theraiserson/airlogger/README.md

# Airlogger

Air quality to MQTT logger

## Breadboard
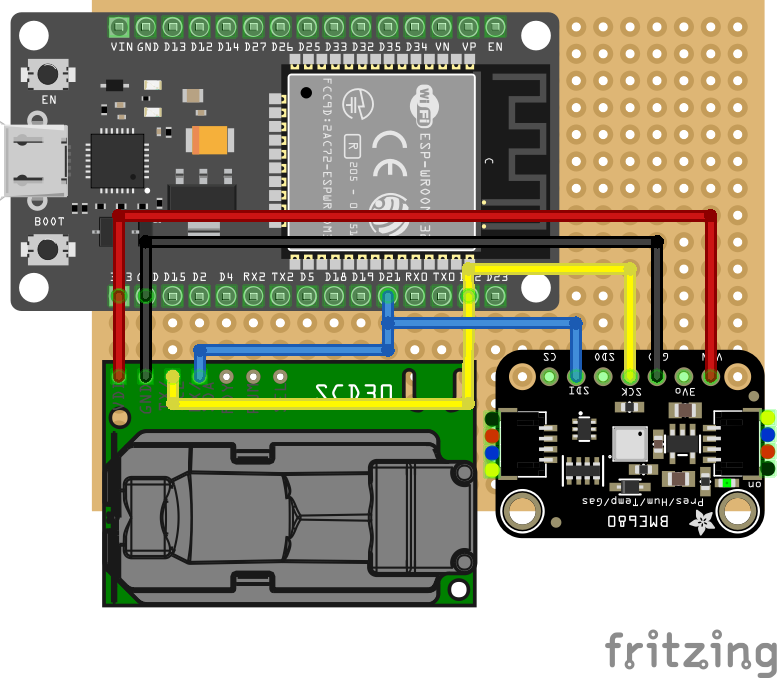
[picture p1: docs/Airlogger_bb.png]
Breadboard


## Schematic
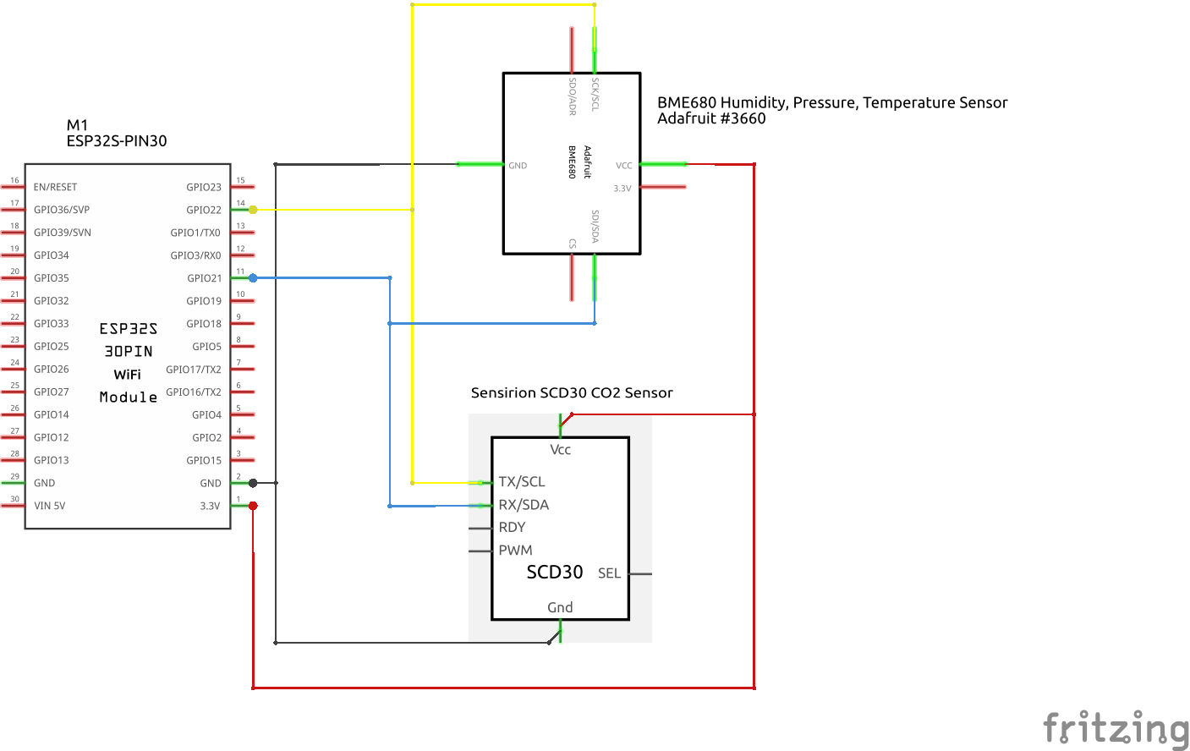
[picture p2: docs/Airlogger_schem.png]
Schematic
