theraiserson/airlogger/docs/case/Airlogger Case Body.FCStd

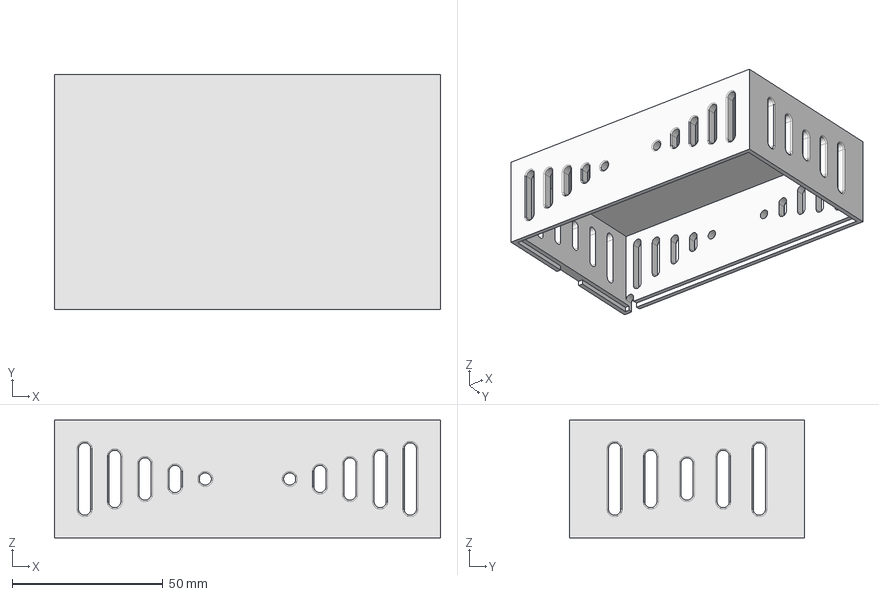
[picture p3: CAD file, 2021-12-17]
docs/case/Airlogger Case Body.FCStd
128.0 x 78.0 x 39.0 mm
