theraiserson/airlogger/docs/case/Airlogger Case Floor.FCStd

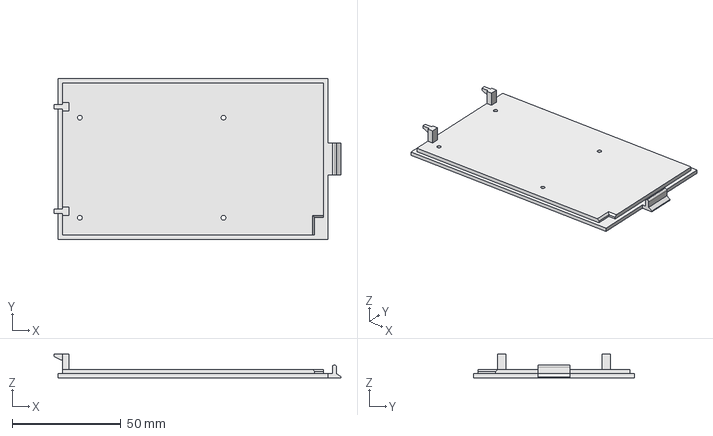
[picture p4: CAD file, 2021-12-17]
docs/case/Airlogger Case Floor.FCStd
131.9 x 74.0 x 10.9 mm
