theraiserson/airlogger/(list of files, cad)

Other CAD files:
docs/case/Airlogger Case Floor.stl
