theraiserson/airlogger/(list of files, drawings)

Other design files:
docs/Airlogger.fzz
