theraiserson/airlogger/(commit log)

2020-11-06 Add support for ESP32
    Project environment for PlatformIO can be choosen in the status bar
2020-11-10 Switch to BSEC and add MQTT
    * Switch from Adafruit BME680 library to BSEC
    * Add basic MQTT publishing to local server
2020-11-29 Fix pressure: Needs to be divided by 100 to reflect hPa
    [main.cpp]
2020-11-29 Read SCD30 in independently timed (5 sec) loop
    Also update SCD30 with pressure readings from BME680 every five minutes
2021-01-24 Setup: Log current SCD30 settings
    Since they are persisted on the sensors memory, they might have
    unexpected values
2021-01-24 Setup: Add 100ms delay to allow SCD30 to boot
    As seen here: https://github.com/sparkfun/OpenLog_Artemis/blob/dd22fdd24059529a46176bd98dd91163d471690a/Firmware/Test%20Sketches/Sensor%20Autodetect/AutoDetectWithMux/menuAttached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
2021-01-24 Setup: Retry once if SCD30 detection failed
    From https://github.com/sparkfun/OpenLog_Artemis/issues/4#issuecomment-624183013
    Also explicitly set auto calibration to false (should be the default
    anyways).
    [main.cpp]
2021-01-28 Re-enable auto calibration
2021-12-07 Add fritzing file
    [Airlogger.fzz]
2021-12-07 Add Breadboard and Schematic images
    [Airlogger.fzz]
2021-12-17 Add case
    [Airlogger Case Body.FCStd, Airlogger Case Floor.FCStd, Airlogger Case Floor.stl]
2022-05-15 Add option to define temperature offset
